atharvach2007/arsenal/j_imgs/Screenshot 2026-06-29 210843.png

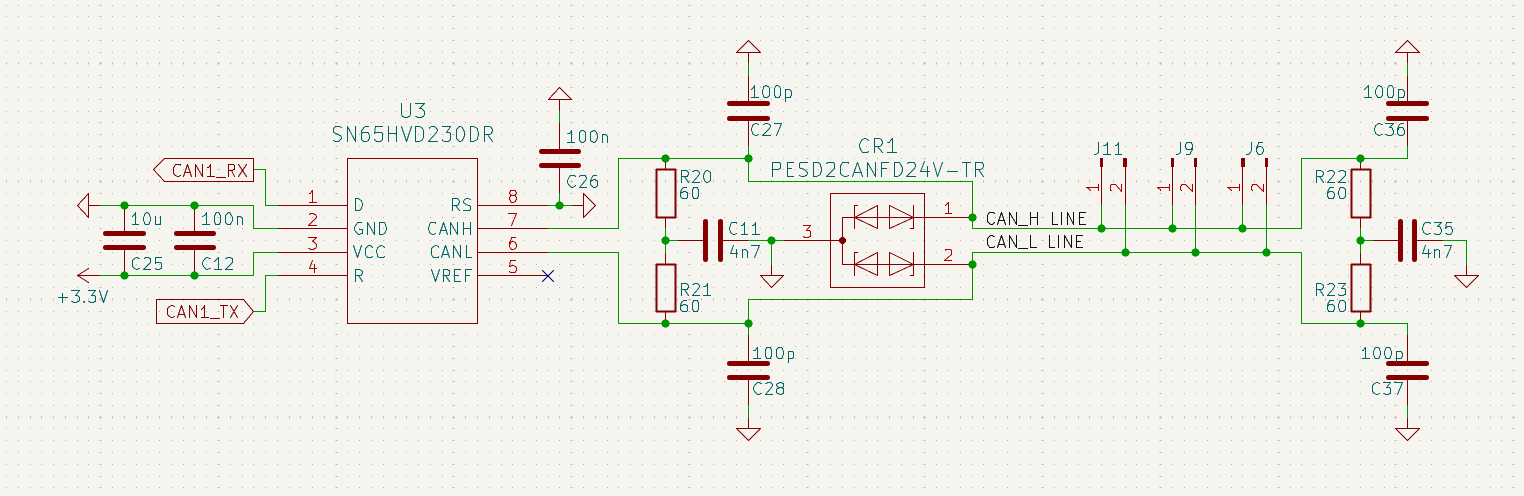
j_imgs/Screenshot 2026-06-29 210843.png
