atharvach2007/arsenal/j_imgs/Screenshot 2026-07-05 224754.png

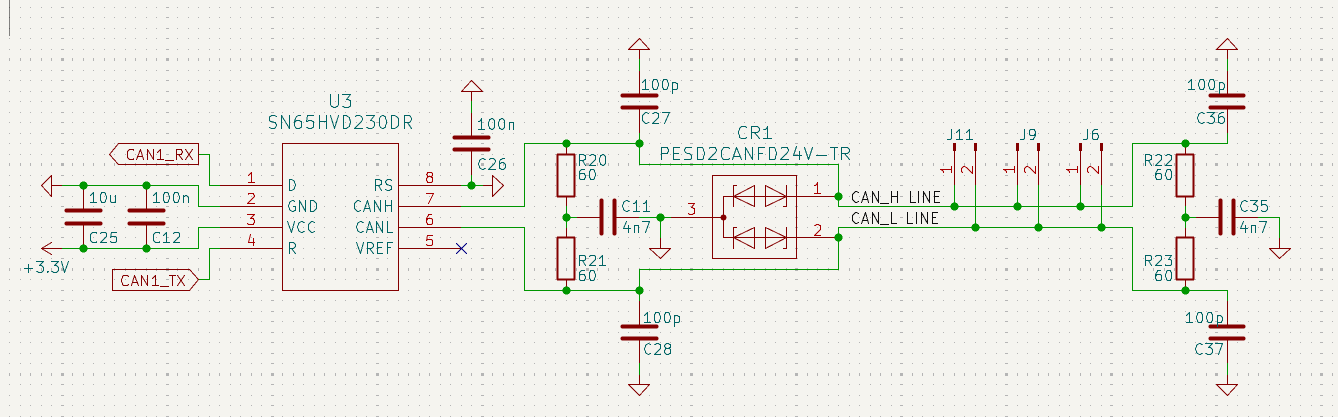
j_imgs/Screenshot 2026-07-05 224754.png
