atharvach2007/arsenal/assets/3D/SOT89-5_DIO.step

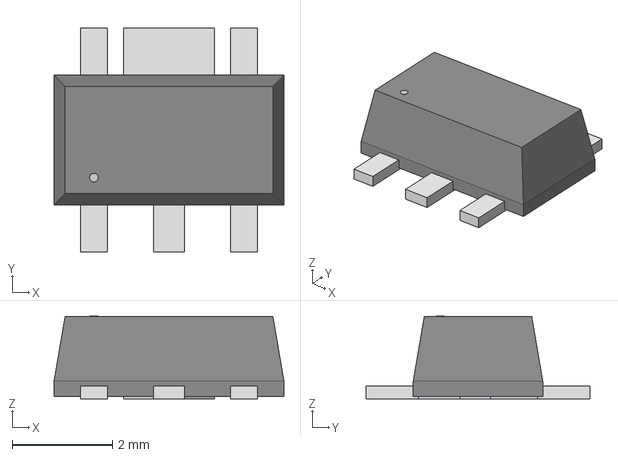
[picture p4: CAD file, 2026-06-28]
assets/3D/SOT89-5_DIO.step
4.60 x 4.47 x 1.65 mm
