atharvach2007/arsenal/assets/3D/XT60PW-M.stp

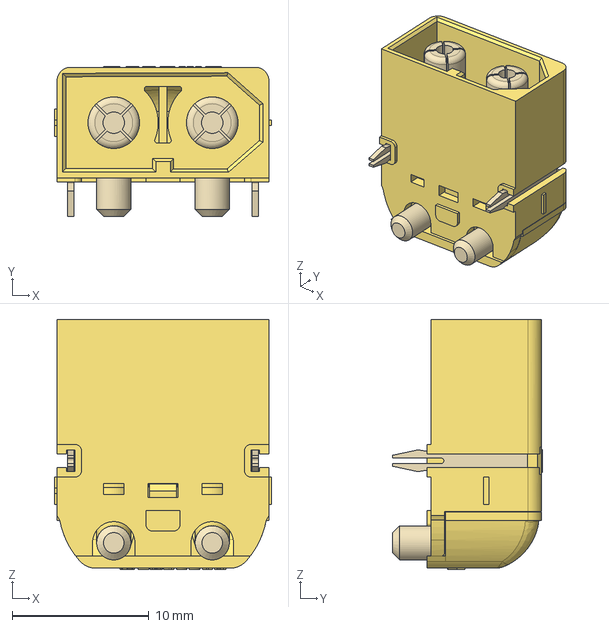
[picture p5: CAD file, 2026-06-28]
assets/3D/XT60PW-M.stp
15.9 x 10.9 x 18.3 mm
