atharvach2007/arsenal/assets/3D/TMC2209_SILENTSTEPSTICK.step

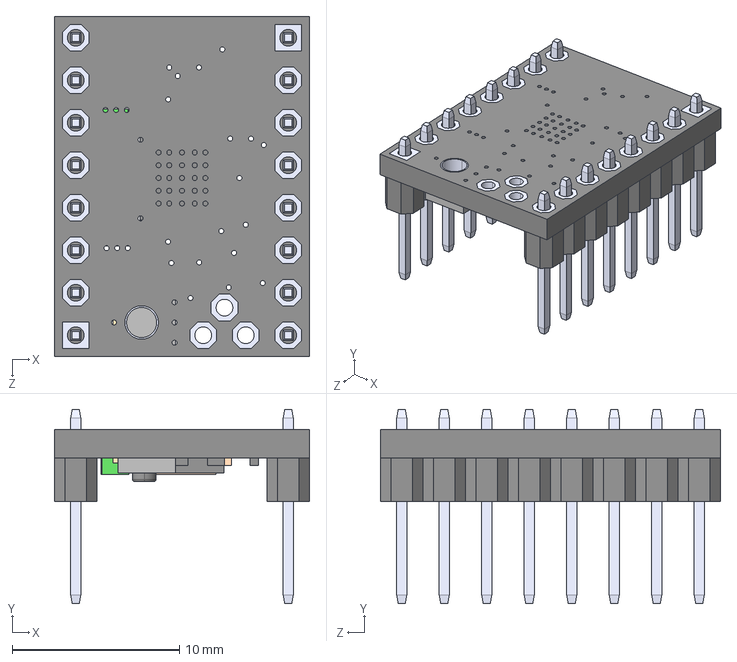
[picture p6: CAD file, 2026-06-28]
assets/3D/TMC2209_SILENTSTEPSTICK.step
15.2 x 11.6 x 20.3 mm
