atharvach2007/arsenal/assets/3D/STM32F446RET6.stp

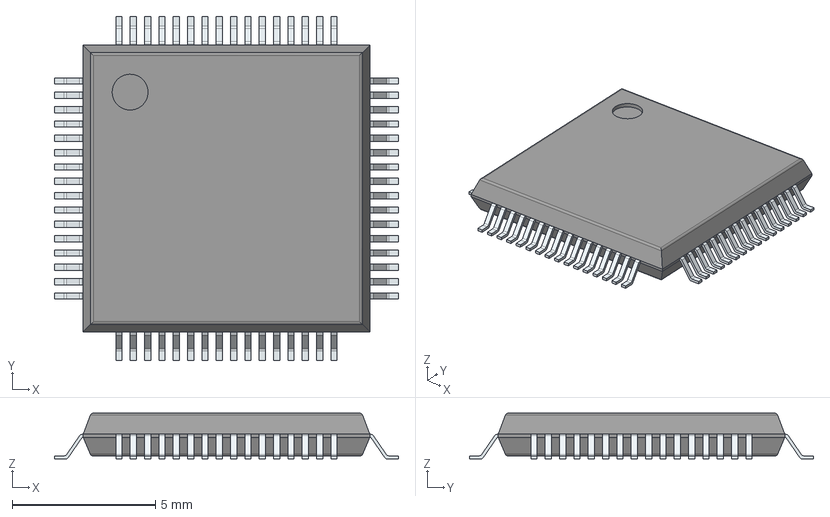
[picture p7: CAD file, 2026-05-29]
assets/3D/STM32F446RET6.stp
12.0 x 12.0 x 1.60 mm
PinsArrayLR
PinsArrayTB
