atharvach2007/arsenal/assets/3D/TPS54331DR.stp

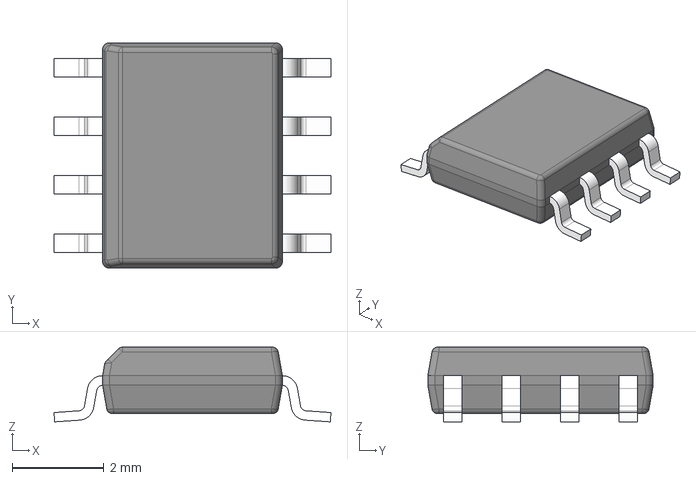
[picture p8: CAD file, 2026-06-28]
assets/3D/TPS54331DR.stp
6.02 x 4.90 x 1.63 mm
BODY-SO
LEAD-D0008A x 8
