atharvach2007/arsenal/assets/WBDesign1.pdf

## WEBENCH ® Design Report

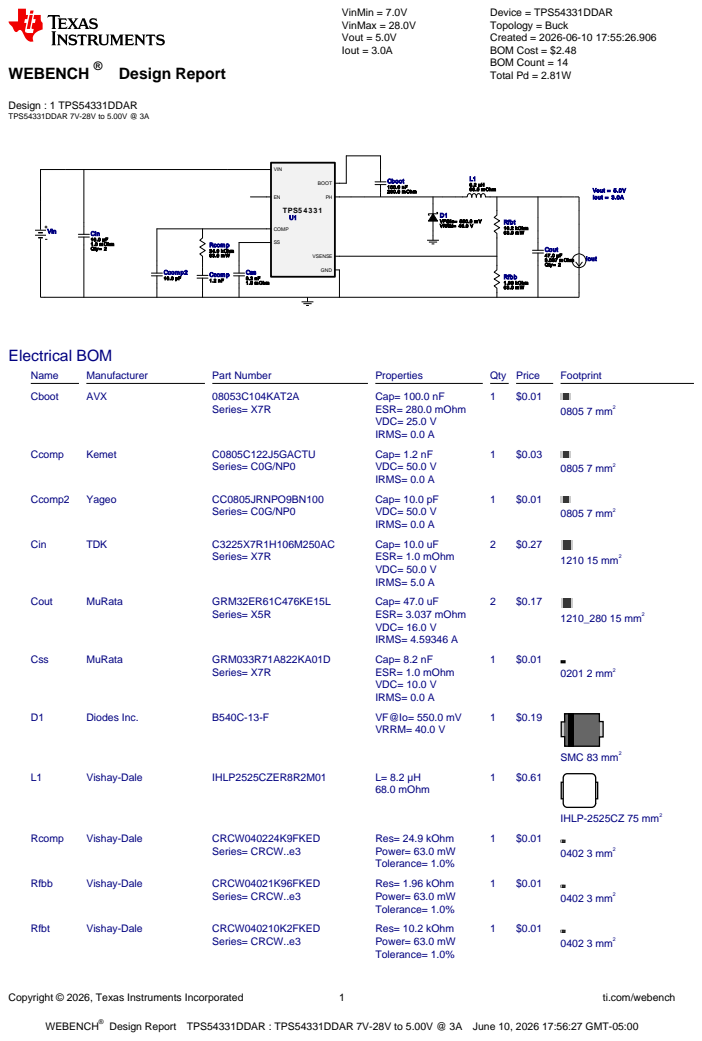
[picture p23: page 1]
Copyright © 2026, Texas Instruments Incorporated; ti.com/webench; WEBENCH®; Design : 1 TPS54331DDAR TPS54331DDAR 7V-28V to 5.00V @ 3A; VinMin = 7.0V VinMax = 28.0V Vout = 5.0V Iout = 3.0A; Device = TPS54331DDAR Topology = Buck Created = 2026-06-10 17:55:26.906 BOM Cost = $2.48 BOM Count = 14 Total Pd = 2.81W; Css 8.2 nF 1.0 m Ohm; Ccom p2 10.0 pF; TPS5 4 3 3 1; BOOT; VIN; VSENSE; COMP; GND; Rfbb 1.96 kOhm 63.0 m W; Cboot 100.0 nF 280.0 m Ohm; Cin 10.0 µF 1.0 m Ohm Qty= 2; L1 8.2 µH 68.0 m Ohm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

Design Report TPS54331DDAR : TPS54331DDAR 7V-28V to 5.00V @ 3A June 10, 2026 17:56:27 GMT-05:00

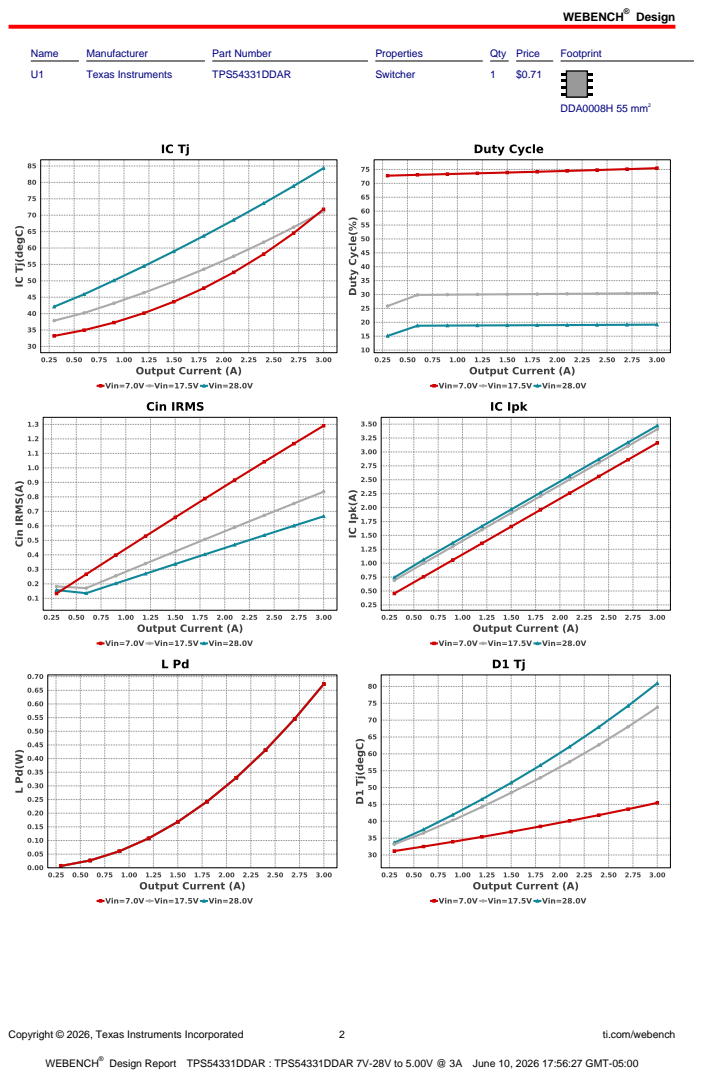
[picture p24: page 2]
Design; Copyright © 2026, Texas Instruments Incorporated; ti.com/webench; Name; Manufacturer; Part Number; Properties; Qty Price; Footprint; Texas Instruments; TPS54331DDAR; Switcher; DDA0008H 55 mm²

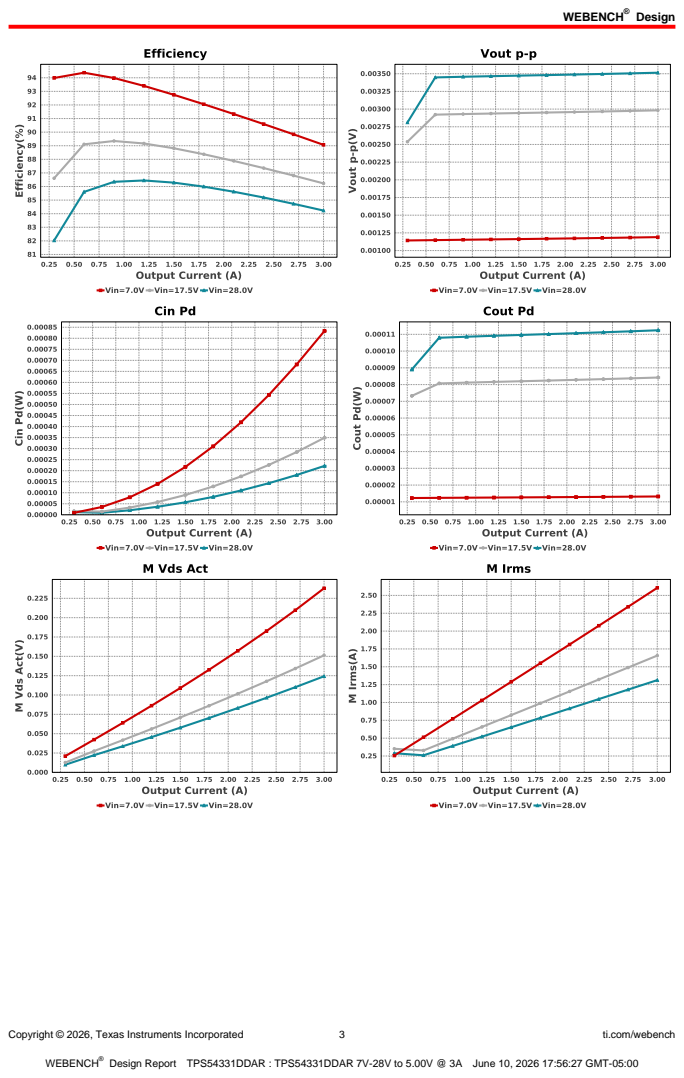
[picture p25: page 3]
Copyright © 2026, Texas Instruments Incorporated; ti.com/webench

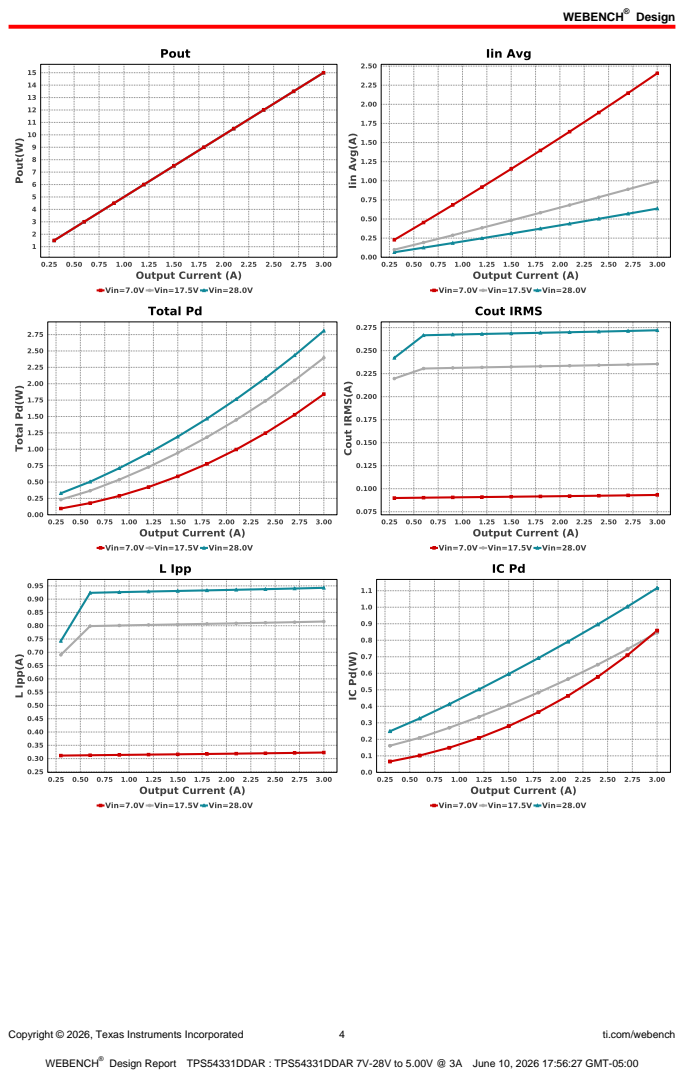
[picture p26: page 4]
Copyright © 2026, Texas Instruments Incorporated; ti.com/webench

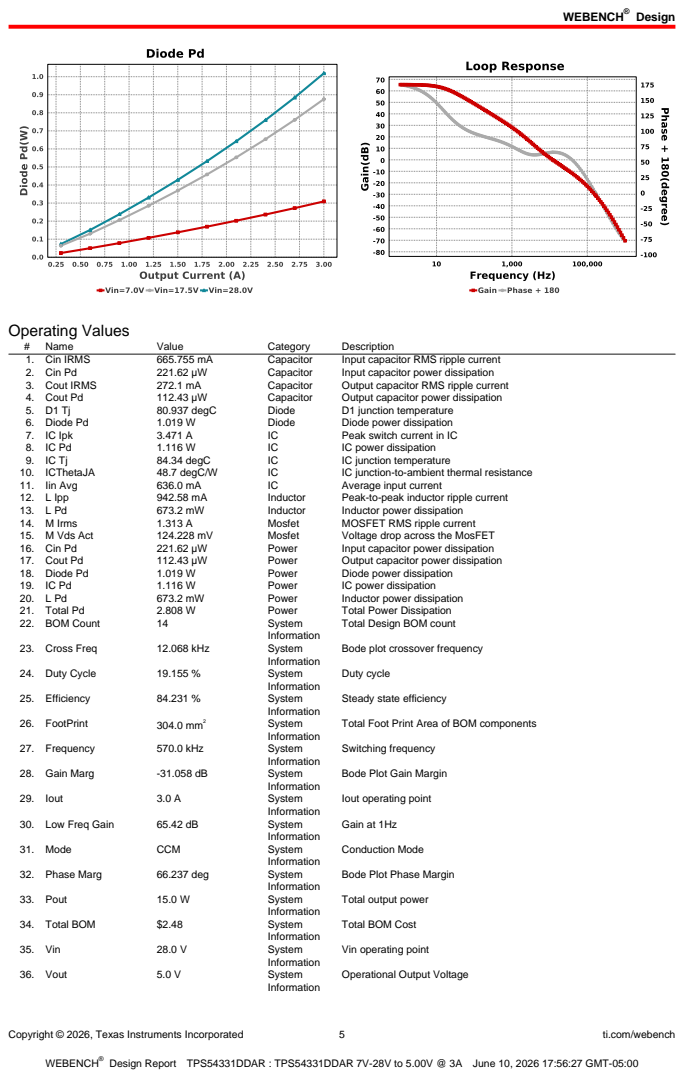
[picture p27: page 5]
Copyright © 2026, Texas Instruments Incorporated; ti.com/webench; Operating Values; Name; Value; Category; Description; 1. Cin IRMS; Capacitor; Input capacitor RMS ripple current; 2. Cin Pd; Input capacitor power dissipation; 3. Cout IRMS; Output capacitor RMS ripple current; 4. Cout Pd; Output capacitor power dissipation; 80.937 degC; Diode; D1 junction temperature; 6. Diode Pd; Diode power dissipation; 7. IC Ipk; Peak switch current in IC; IC power dissipation; 84.34 degC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

Total Design BOM count

Bode plot crossover frequency

Steady state efficiency

Total Foot Print Area of BOM components

Bode Plot Gain Margin

Iout operating point

Bode Plot Phase Margin

Total output power

Total BOM Cost

Vin operating point

Operational Output Voltage

Copyright © 2026, Texas Instruments Incorporated | 6 | ti.com/webench
# | Name | Value | Category | Description

37. Vout Actual | 4.963 V | System
| | | Information | Vout Actual calculated based on selected voltage divider resistors
38. Vout Tolerance | 5.254 % | System
| | | Information | Vout Tolerance based on IC Tolerance (no load) and voltage divider resistors if applicable
39. Vout p-p | 3.514 mV | System
| | | Information | Peak-to-peak output ripple voltage

## Design Inputs

Name | Value | Description
Iout | 3.0 | Maximum Output Current
VinMax | 28.0 | Maximum input voltage
VinMin | 7.0 | Minimum input voltage
Vout | 5.0 | Output Voltage
| base_pn | | TPS54331 | Base Product Number
source | DC | Input Source Type
Ta | 30.0 | Ambient temperature


Copyright © 2026, Texas Instruments Incorporated | 7 | ti.com/webench

## Assembly

## Component Testing

Some published data on components in datasheets such as Capacitor ESR and Inductor DC resistance is based on conservative values that will guarantee that the components always exceed the specification. For design purposes it is usually better to work with typical values. Since this data is not always available it is a good practice to measure the Capacitance and ESR values of Cin and Cout, and the inductance and DC resistance of L1 before assembly of the board. Any large discrepancies in values should be electrically simulated in WEBENCH to check for instabilities and thermally simulated in WebTHERM to make sure critical temperatures are not exceeded.

## Soldering Component to Board

If board assembly is done in house it is best to tack down one terminal of a component on the board then solder the other terminal. For surface mount parts with large tabs, such as the DPAK, the tab on the back of the package should be pre-tinned with solder, then tacked into place by one of the pins. To solder the tab town to the board place the iron down on the board while resting against the tab, heating both surfaces simultaneously. Apply light pressure to the top of the plastic case until the solder flows around the part and the part is flush with the PCB. If the solder is not flowing around the board you may need a higher wattage iron (generally 25W to 30W is enough).

## Initial Startup of Circuit

It is best to initially power up the board by setting the input supply voltage to the lowest operating input voltage 7.0V and set the input supply's current limit to zero. With the input supply off connect up the input supply to Vin and GND. Connect a digital volt meter and a load if needed to set the minimum Iout of the design from Vout and GND. Turn on the input supply and slowly turn up the current limit on the input supply. If the voltage starts to rise on the input supply continue increasing the input supply current limit while watching the output voltage. If the current increases on the input supply, but the voltage remains near zero, then there may be a short or a component misplaced on the board. Power down the board and visually inspect for solder bridges and recheck the diode and capacitor polarities. Once the power supply circuit is operational then more extensive testing may include full load testing, transient load and line tests to compare with simulation results.

## Load Testing

The setup is the same as the initial startup, except that an additional digital voltmeter is connected between Vin and GND, a load is connected between Vout and GND and a current meter is connected in series between Vout and the load. The load must be able to handle at least rated output power + 50% ( 7.5 watts for this design). Ideally the load is supplied in the form of a variable load test unit. It can also be done in the form of suitably large power resistors. When using an oscilloscope to measure waveforms on the prototype board, the ground leads of the oscilloscope probes should be as short as possible and the area of the loop formed by the ground lead should be kept to a minimum. This will help reduce ground lead inductance and eliminate EMI noise that is not actually present in the circuit.

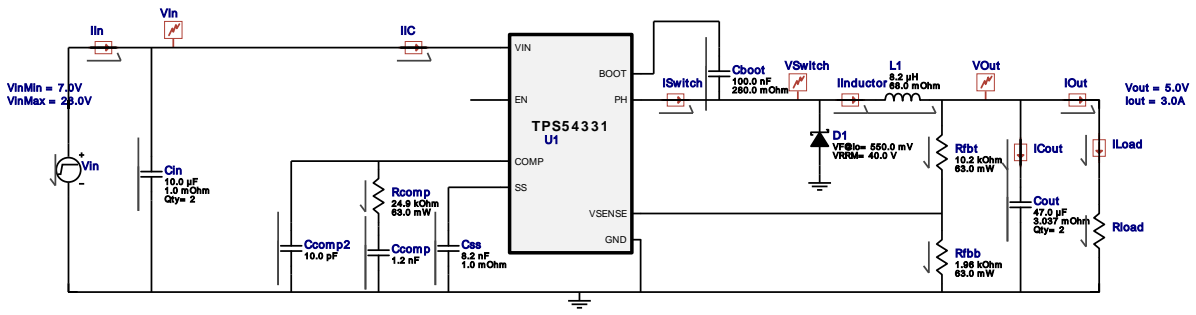
[picture p29: figure]
Css 8.2 nF 1.0 m Ohm; VinMin = 7.0V VinMax = 28.0V; VIn; ISwitch; VSwitch; ICout; Ccom p2 10.0 pF; TPS5 4 3 3 1; BOOT; VIN; VSENSE; COMP; GND; Rfbb 1.96 kOhm 63.0 m W; Cboot 100.0 nF; 280.0 m Ohm; IInductor; IIC; Cin 10.0 µF 1.0 m Ohm Qty= 2; L1 8.2 µH 68.0 m Ohm; Rfbt 10.2 kOhm 63.0 m W; IOut; Cout 47.0 µF 3.037 m Ohm Qty= 2; IIn; D1 VF@Io= 550.0 m V VRRM= 40.0 V; Ccom p 1.2 nF; Rcom p 24.9 kOhm 63.0 m W; Vout = 5.0V Iout = 3.0A; VOut; ILoad; Rload; Vin

Copyright © 2026, Texas Instruments Incorporated | 8 | ti.com/webench

## WEBENCH® Electrical Simulation Report

Design Id = 1
sim_id = 1
Simulation Type = Startup

## Simulation Parameters

# Name Parameter Name | Description | Values

1. Rload R | Load Resistance | 1.6666666666666667 Ohm

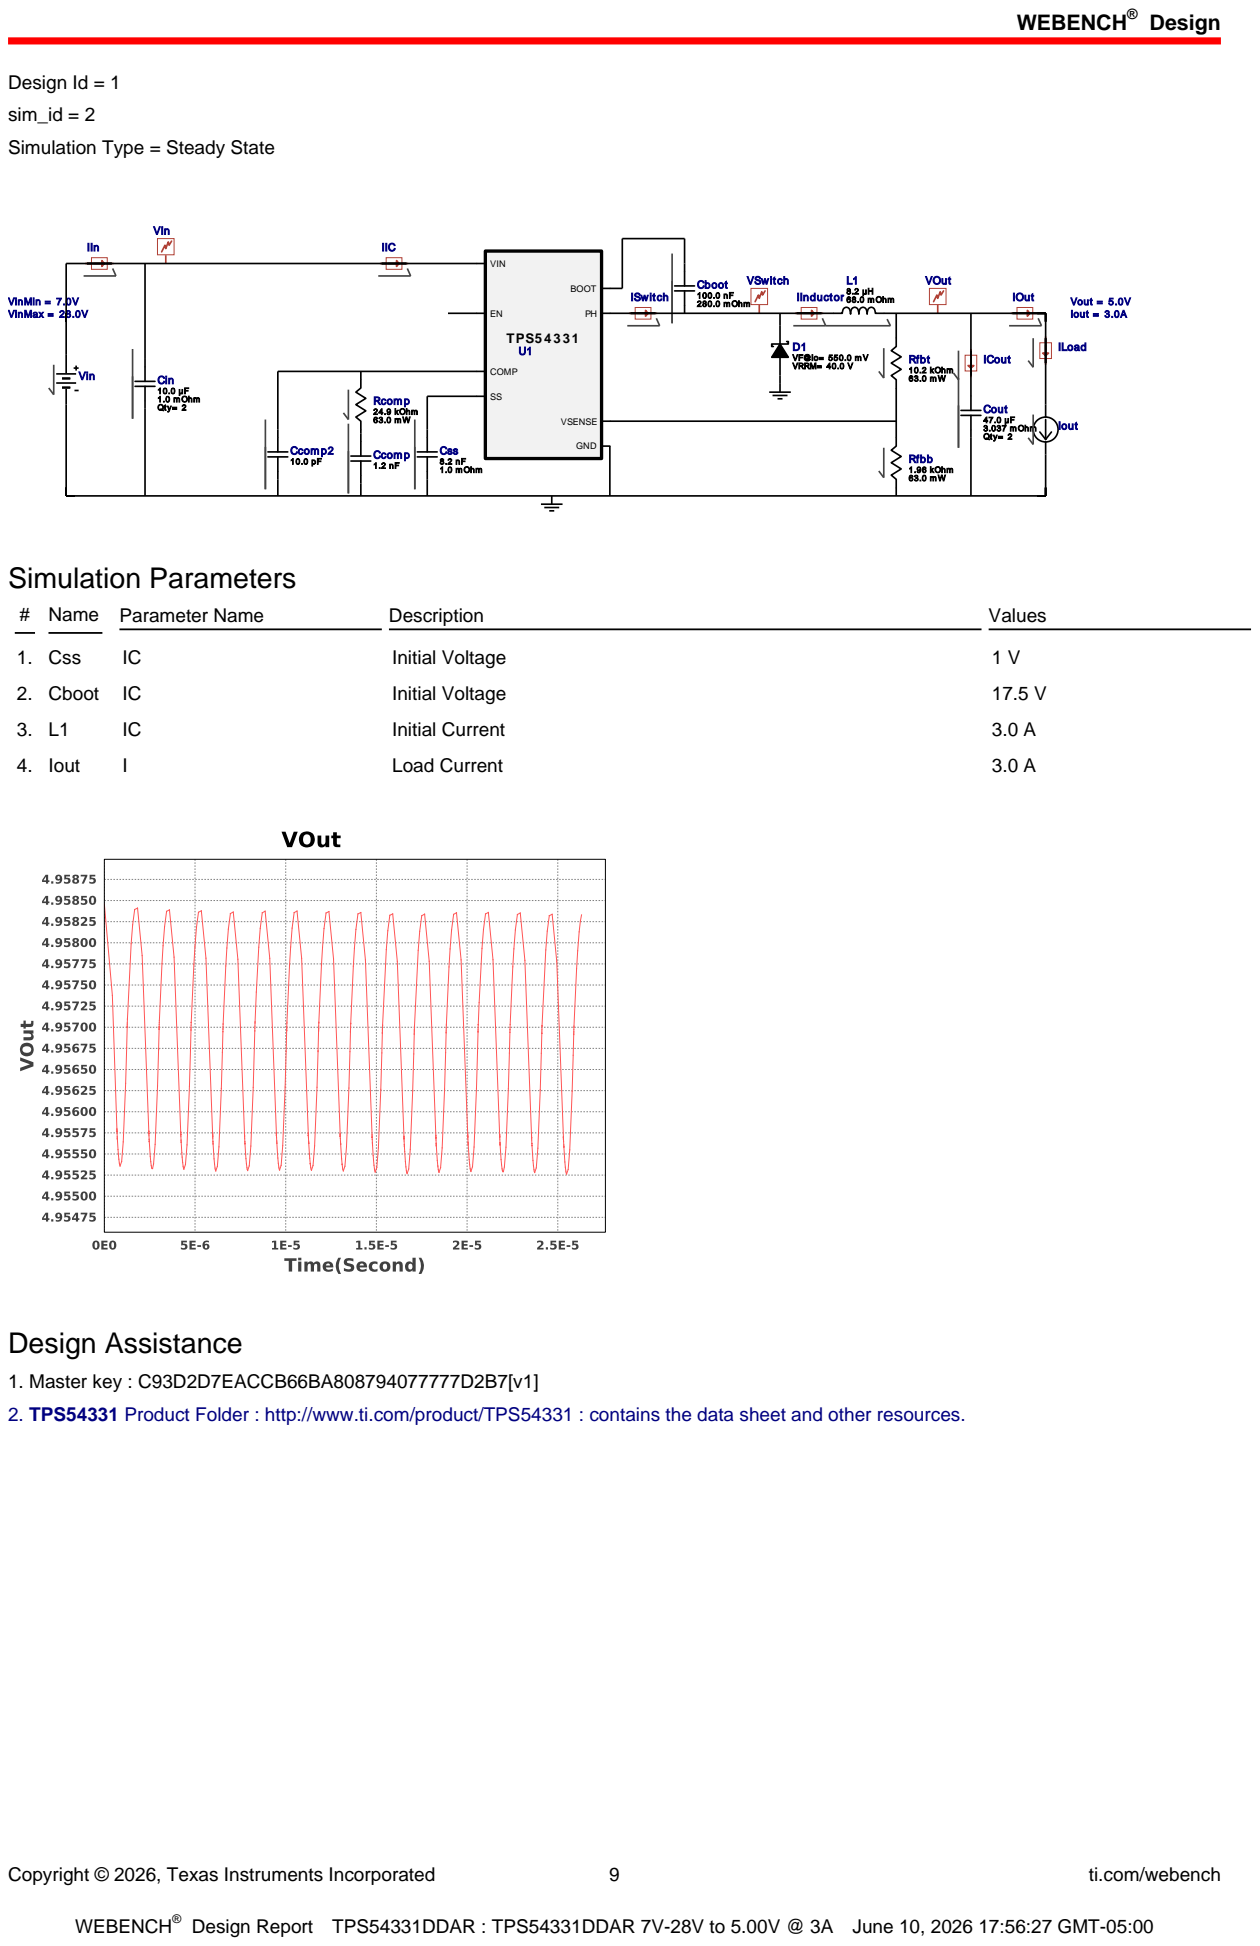
[picture p30: page 9]
Copyright © 2026, Texas Instruments Incorporated; ti.com/webench; Css 8.2 nF 1.0 m Ohm; VinMin = 7.0V VinMax = 28.0V; VIn; ISwitch; VSwitch; ICout; Ccom p2 10.0 pF; TPS5 4 3 3 1; BOOT; VIN; VSENSE; COMP; GND; Rfbb 1.96 kOhm 63.0 m W; Cboot 100.0 nF; 280.0 m Ohm; IInductor; IIC; Cin 10.0 µF 1.0 m Ohm Qty= 2; L1 8.2 µH 68.0 m Ohm; Rfbt 10.2 kOhm 63.0 m W; IOut; Cout 47.0 µF 3.037 m Ohm Qty= 2; IIn; D1 VF@Io= 550.0 m V VRRM= 40.0 V; Ccom p 1.2 nF; Rcom p 24.9 kOhm 63.0 m W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

Design Id = 1
sim_id = 2
Simulation Type = Steady State

1. Master key : C93D2D7EACCB66BA808794077777D2B7[v1]
2. TPS54331 Product Folder : http://www.ti.com/product/TPS54331 : contains the data sheet and other resources.

Copyright © 2026, Texas Instruments Incorporated | 10 | ti.com/webench

Important Notice and Disclaimer

TI provides technical and reliability data (including datasheets), design resources (including reference designs), application or other design advice, web tools, safety information, and other resources AS IS and with all faults, and disclaims all warranties. These resources are intended for skilled developers designing with TI products. You are solely responsible for (1) selecting the appropriate TI products for your application, (2) designing, validating and testing your application, and (3) ensuring your application meets applicable standards, and any other safety, security, or other requirements.

These resources are subject to change without notice. TI grants you permission to use these resources only for development of an application that uses the TI products described in the resource. Other reproduction and display of these resources is prohibited. No license is granted to any other TI intellectual property right or to any third party intellectual property right. TI disclaims responsibility for, and you will fully indemnify TI and its representatives against, any claims, damages, costs, losses, and liabilities arising out of your use of these resources.

Providing these resources does not expand or otherwise alter TI's applicable Terms of Sale or other applicable terms available either on ti.com or provided in conjunction with TI products.
