atharvach2007/arsenal/Stage1 - STM/voxboard/voxboard.pdf

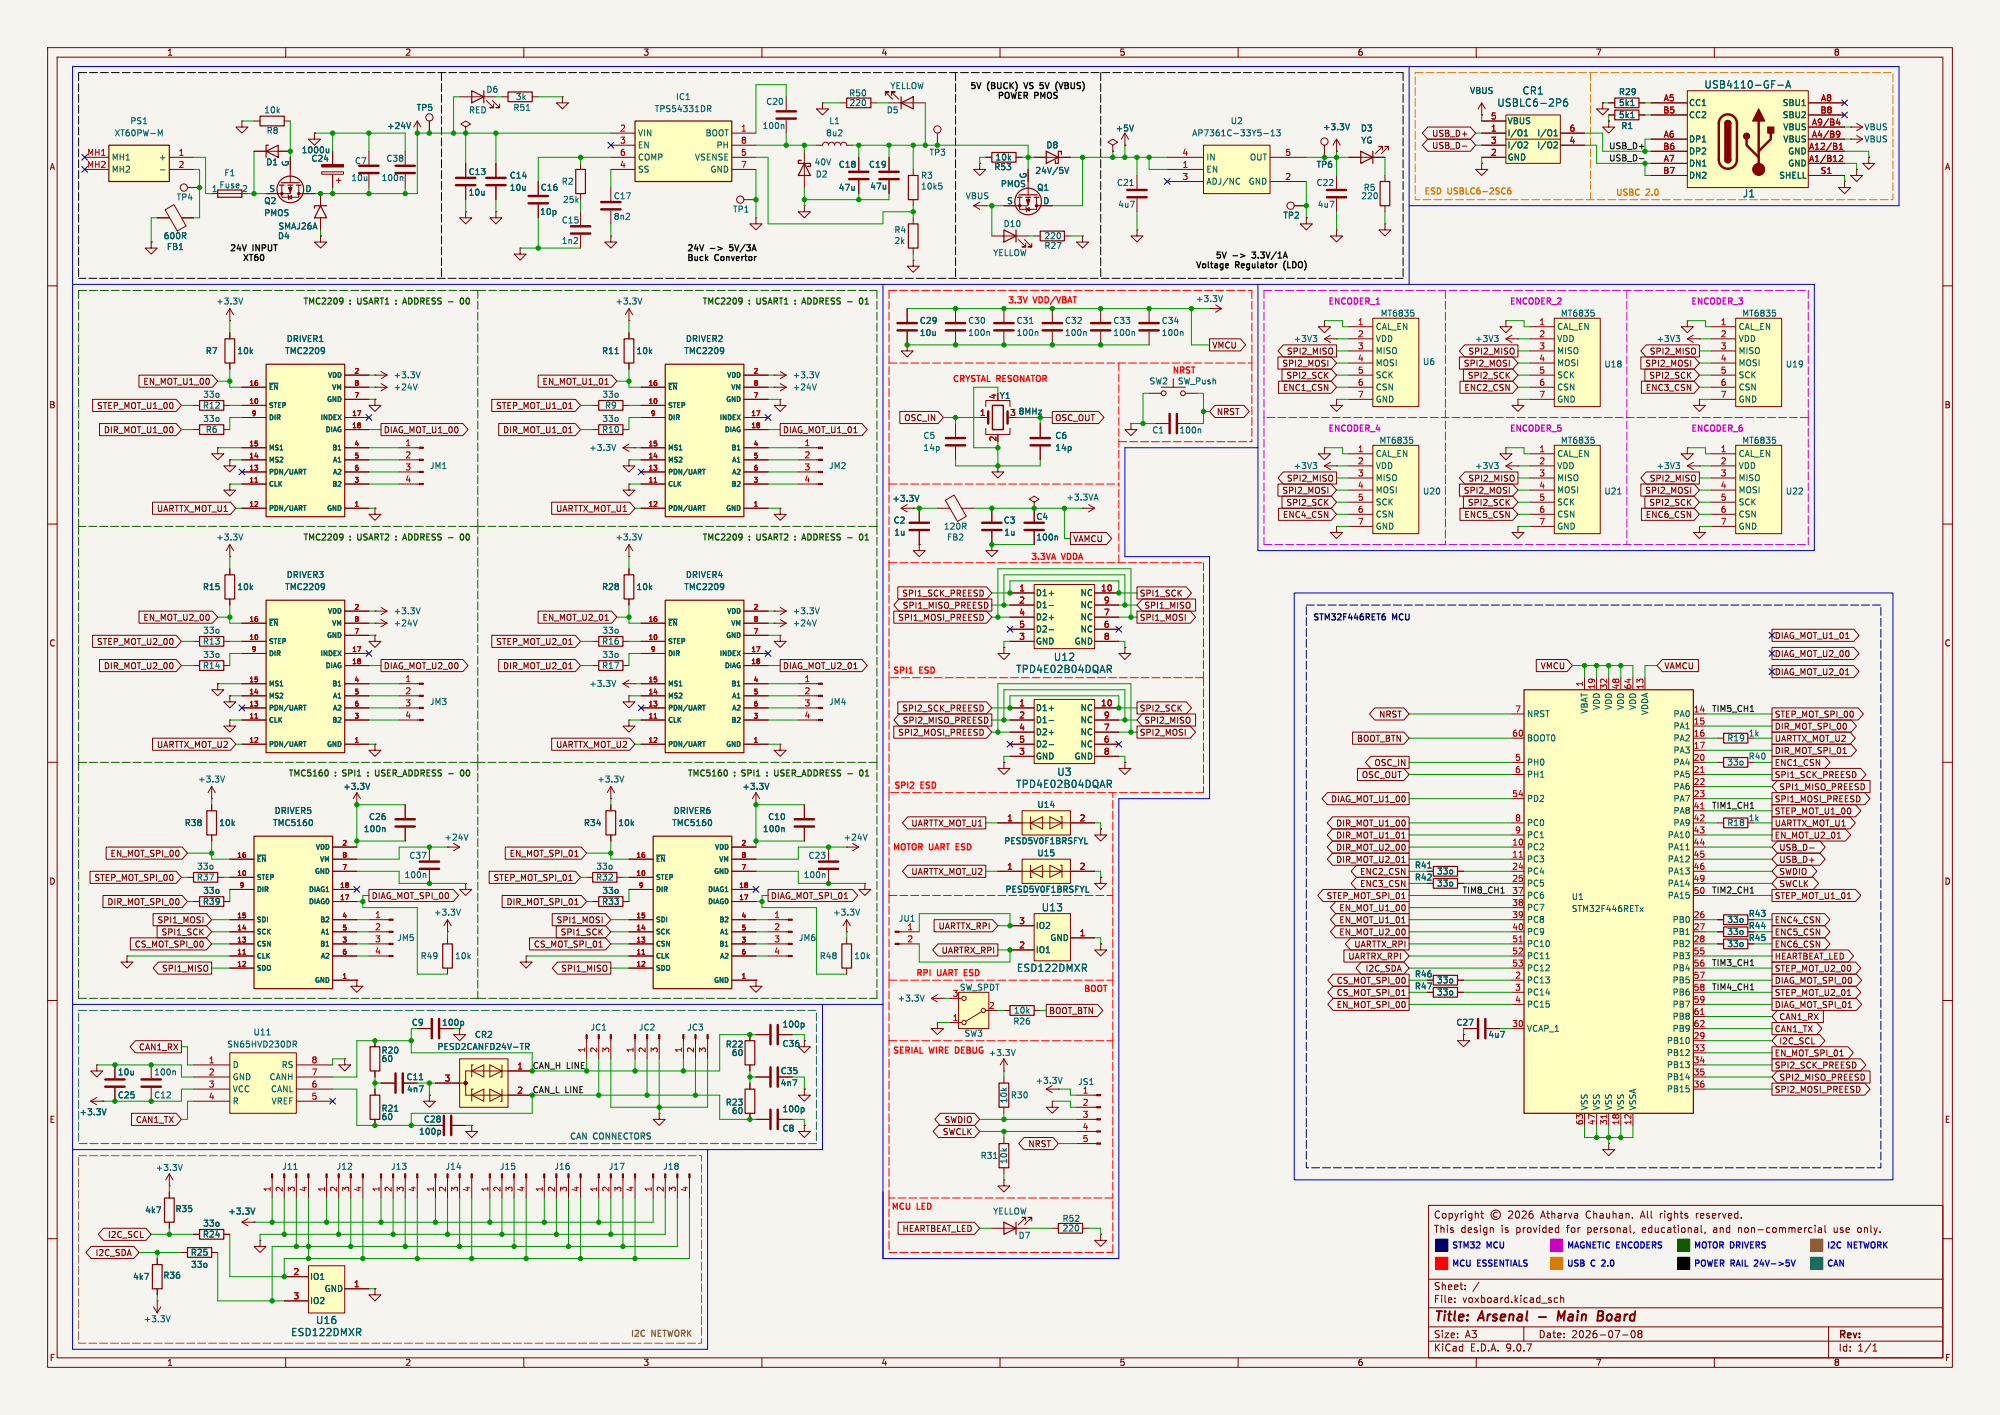
[picture p31: page 1]

5V (BUCK) VS 5V (VBUS) POWER PMOS

SPI1 ESD MOTOR UART ESD

1 VSS 63 VDD 19 VSS 47 VDD 32 VSS 31 VDD 48 VSS 18 VDD 64 VSSA 12 VDDA 13 PA0

Id: 1/1 Title: Arsenal - Main Board
