atharvach2007/arsenal/Stage1 - STM/voxboard/voxboard.kicad_pcb

## KiCad design Stage1 - STM/voxboard/voxboard.kicad_pcb (2026-07-23)

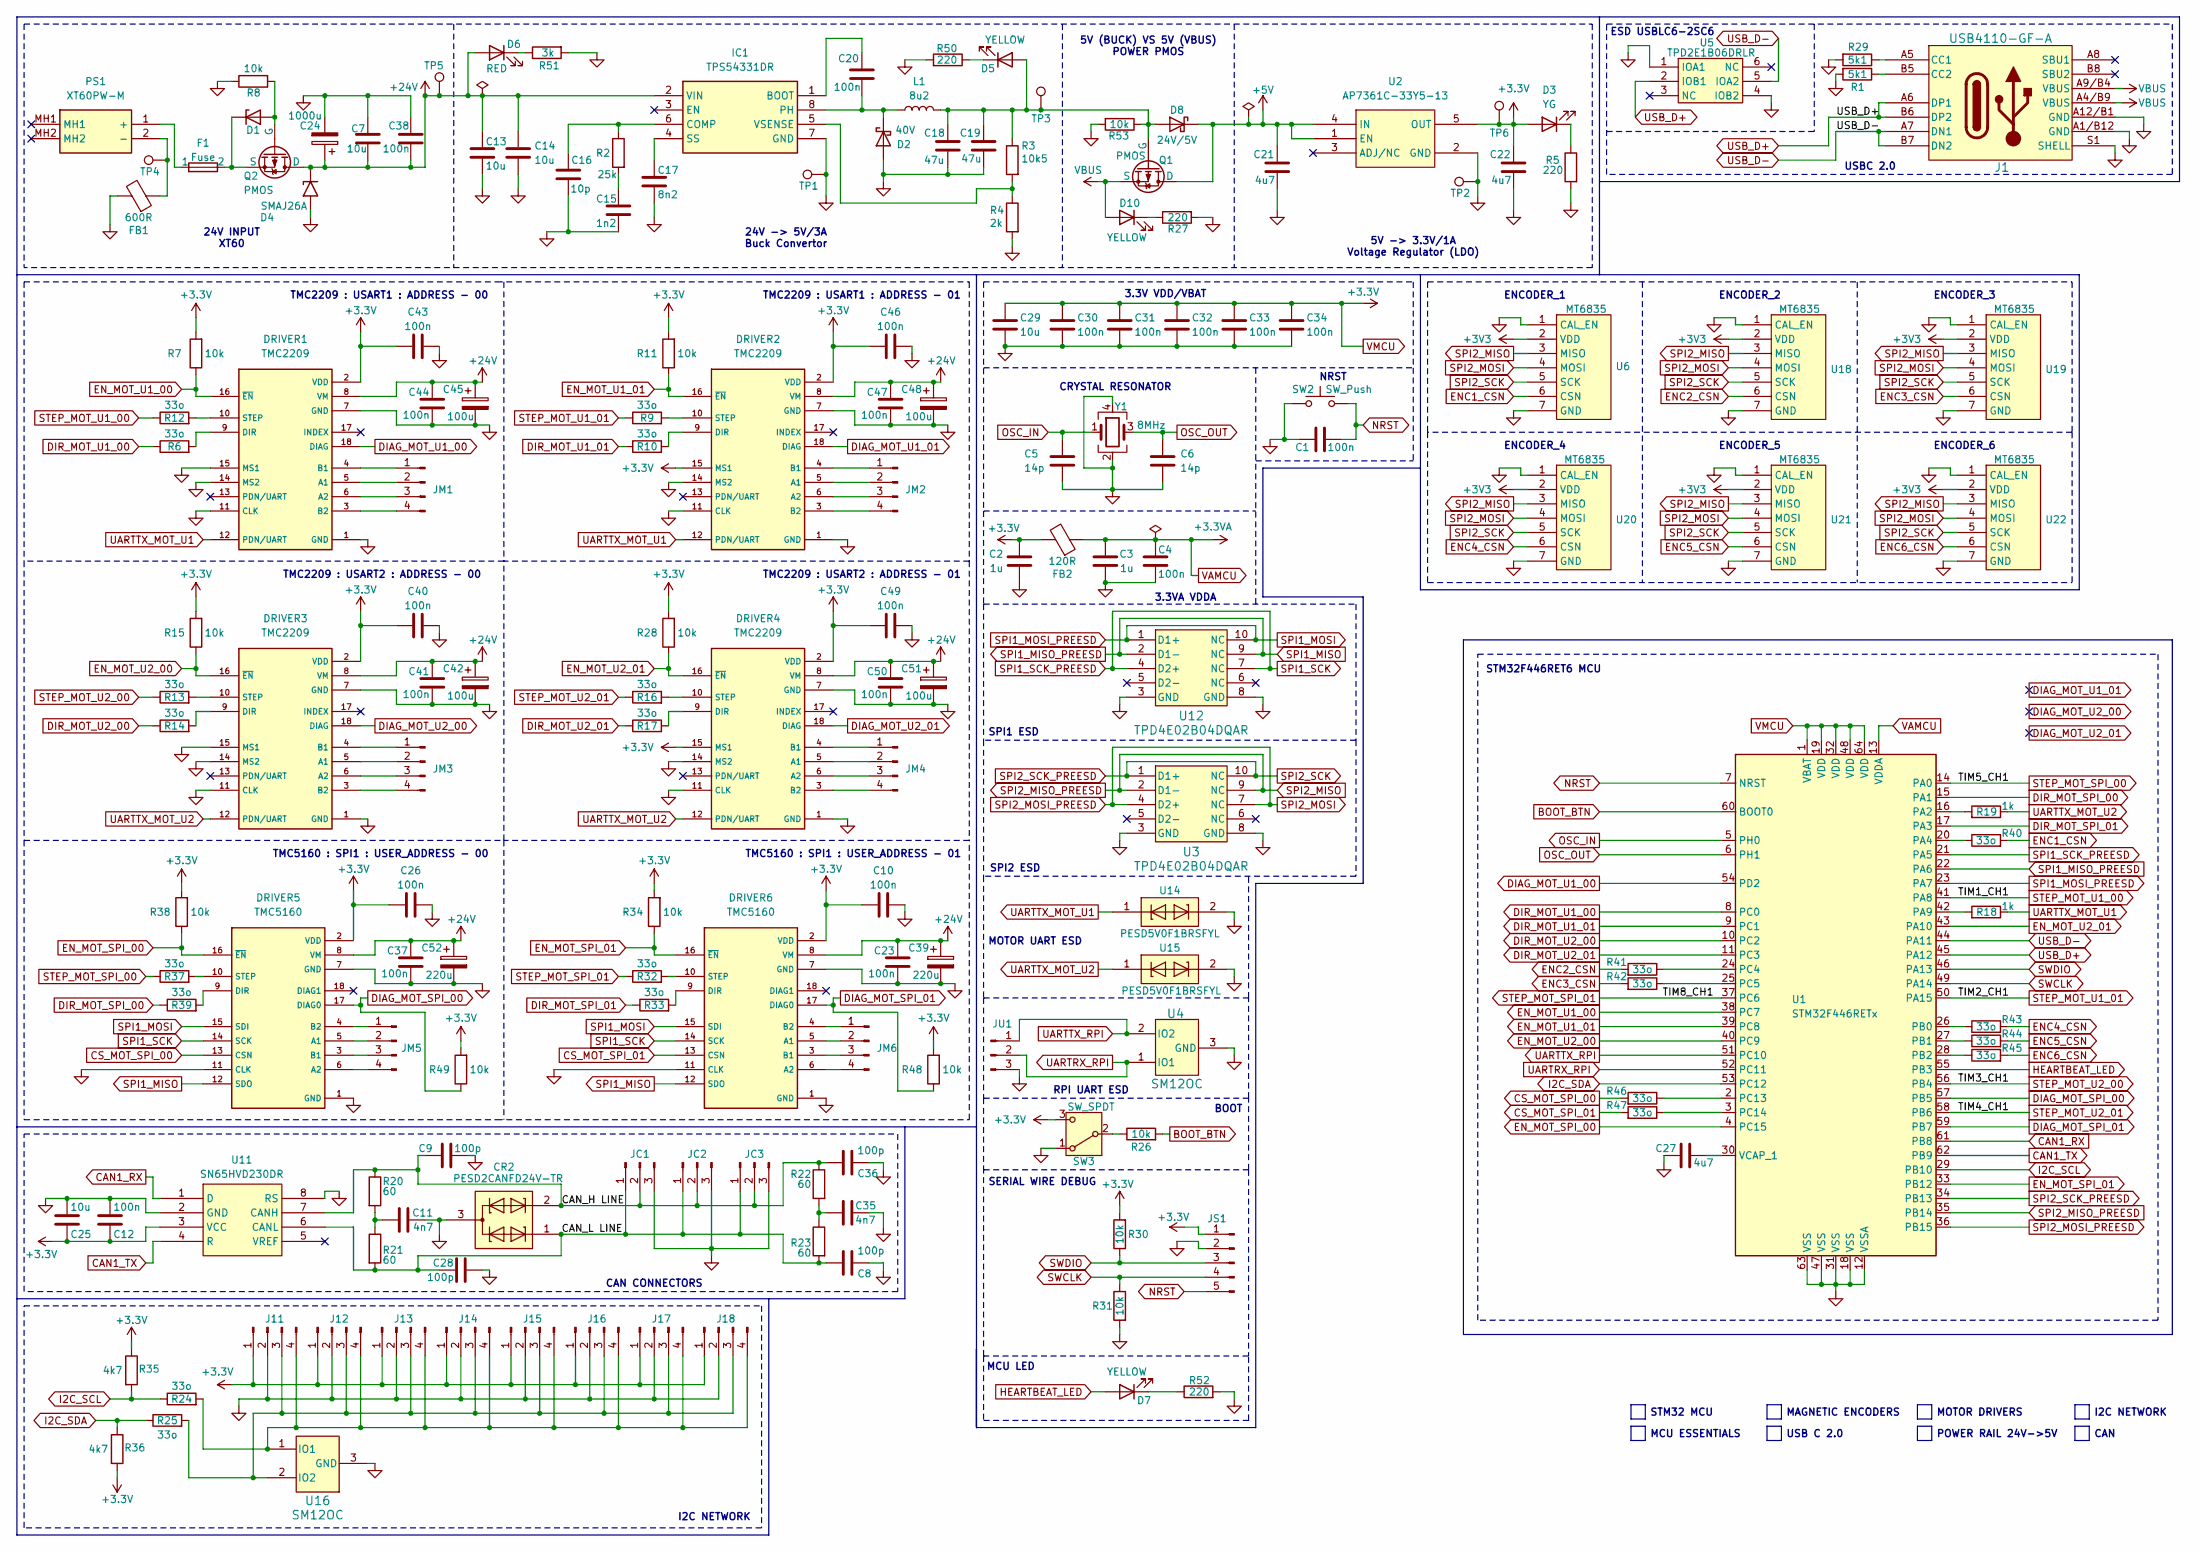
[picture p32: schematic voxboard.kicad_sch, Arsenal - Main Board]

Parts:
C1, C4, C10, C12, C23, C26, C30, C31, C32, C33, C34, C37, C38, C40, C41, C43, C44, C46, C47, C49, C50: 100n; C_0402_1005Metric
C2, C3: 1u; C_0603_1608Metric
C5, C6: 14p; C_0402_1005Metric
C7, C25, C29: 10u; C_0603_1608Metric
C8, C9, C28, C36: 100p; C_0402_1005Metric
C11, C35: 4n7; C_0402_1005Metric
C13, C14: 10u; C_1210_3225Metric
C15: 1n2; C_0805_2012Metric
C16: 10p; C_0805_2012Metric
C17: 8n2; C_0201_0603Metric
C18, C19: 47u; C_1210_3225Metric
C20: 100n; C_0805_2012Metric
C21, C22, C27: 4u7; C_0603_1608Metric
C24: 1000u; CP_Radial_D8.0mm_P3.50mm
C39, C52: 220u; CP_Radial_D10.0mm_P5.00mm
C42, C45, C48, C51: 100u; CP_Radial_D8.0mm_P3.50mm
CR2: PESD2CANFD24V-TR; SOT-23
D1: D_Zener; D_SOD-123
D2: 40V; D_SMA
D3: YG; LED_0603_1608Metric
D4: SMAJ26A; D_SMA
D5, D10: YELLOW; LED_0603_1608Metric
D6: RED; LED_0603_1608Metric
D7: YELLOW; LED_0805_2012Metric
D8: 24V/5V; D_SMC
DRIVER1, DRIVER2, DRIVER3, DRIVER4: TMC2209; MODULE_TMC2209_5160
DRIVER5, DRIVER6: TMC5160; MODULE_TMC2209_5160
F1: Fuse; CONN_3557-2_KEY
FB1: 600R; L_1210_3225Metric
FB2: 120R; L_0603_1608Metric
IC1: TPS54331DR; SOIC-8_3.9x4.9mm_P1.27mm
J1: USB4110-GF-A; USB_C_Receptacle_GCT_USB4110
J11, J12, J13, J14, J15, J16, J17, J18: Conn_01x04_Pin; JST_GH_BM04B-GHS-TBT_1x04-1MP_P1.25mm_Vertical
JC1, JC2, JC3: Conn_01x03_Pin; JST_GH_BM03B-GHS-TBT_1x03-1MP_P1.25mm_Vertical
JM1, JM2, JM3, JM4, JM5, JM6: Conn_01x04_Pin; JST_VH_B4P-VH-FB-B_1x04_P3.96mm_Vertical
JS1: Conn_01x05_Pin; PinHeader_1x05_P2.54mm_Vertical
JU1: Conn_01x03_Pin; PinHeader_1x03_P2.54mm_Vertical
L1: 8u2; L_KOHERELEC_MDA7050_7.3x6.6mm
PS1: XT60PW-M; AMASS_XT60PW-M_1x02_P7.20mm_Horizontal
Q1: PMOS; SOT-23
Q2: PMOS; TO-252-2
R1, R29: 5k1; R_0402_1005Metric
R2: 25k; R_0402_1005Metric
R3: 10k5; R_0402_1005Metric
R4: 2k; R_0402_1005Metric
R5, R27, R50, R52: 220; R_0402_1005Metric
R6, R9, R10, R12, R13, R14, R16, R17, R24, R25, R32, R33, R37, R39, R40, R41, R42, R43, R44, R45, R46, R47: 33o; R_0402_1005Metric
R7, R8, R11, R15, R26, R28, R30, R31, R34, R38, R48, R49, R53: 10k; R_0402_1005Metric
R18, R19: 1k; R_0402_1005Metric
R20, R21, R22, R23: 60; R_0603_1608Metric
R35, R36: 4k7; R_0402_1005Metric
R51: 3k; R_0402_1005Metric
SW2: SW_Push; SW_PUSH_B3U-1000PM
SW3: SW_SPDT; SW_SPDT_PCM12
TP1, TP2, TP4: TestPoint; TestPoint_Pad_2.0x2.0mm
TP3, TP5, TP6: TestPoint; TestPoint_Pad_D2.0mm
U1: STM32F446RETx; LQFP64-10x10mm
U2: AP7361C-33Y5-13; AP7361C-33Y5-13_SOT89-5_DIO
U3, U12: TPD4E02B04DQAR; USON-10_2.5x1.0mm_P0.5mm
U4, U16: SM12OC; SOT-23
U5: TPD2E1B06DRLR; SOT-666
U6, U18, U19, U20, U21, U22: MT6835; JST_GH_BM07B-GHS-TBT_1x07-1MP_P1.25mm_Vertical
U11: SN65HVD230DR; SOIC-8_3.9x4.9mm_P1.27mm
U14, U15: PESD5V0F1BRSFYL; Nexperia_DSN0603-2_0.6x0.3mm_P0.4mm
Y1: 8MHz; Crystal_SMD_3225-4Pin_3.2x2.5mm

Connections:
+3V3: U6.2 (VDD), U18.2 (VDD), U19.2 (VDD), U20.2 (VDD), U21.2 (VDD), U22.2 (VDD)
+5V: C21.1, D8.1 (K), Q1.1 (D), U2.1 (EN), U2.4 (IN)
+24V: C7.2, C13.1, C14.1, C23.1, C24.1, C37.1, C38.2, C39.1, C41.1, C42.1, C44.1, C45.1, C47.1, C48.1, C50.1, C51.1, C52.1, D4.1 (A1), D6.2 (A), DRIVER1.8 (VM), DRIVER2.8 (VM), DRIVER3.8 (VM), DRIVER4.8 (VM), DRIVER5.8 (VM), DRIVER6.8 (VM), IC1.2 (VIN), Q2.1 (D), TP5.1
/CAN_H LINE: C9.1, C36.1, CR2.2, JC1.2, JC2.2, JC3.2, R20.1, R22.1, U11.7 (CANH)
/CAN_L LINE: C8.1, C28.1, CR2.1, JC1.1, JC2.1, JC3.1, R21.2, R23.2, U11.6 (CANL)
BOOT_BTN: R26.2, U1.60 (BOOT0)
CAN1_RX: U1.61 (PB8), U11.1 (D)
CAN1_TX: U1.62 (PB9), U11.4 (R)
CS_MOT_SPI_00: DRIVER5.13 (CSN), R46.2
CS_MOT_SPI_01: DRIVER6.13 (CSN), R47.2
DIAG_MOT_SPI_00: DRIVER5.17 (DIAG0), R49.1, U1.57 (PB5)
DIAG_MOT_SPI_01: DRIVER6.17 (DIAG0), R48.1, U1.59 (PB7)
DIAG_MOT_U1_00: DRIVER1.18 (DIAG), U1.54 (PD2)
DIAG_MOT_U1_01: DRIVER2.18 (DIAG)
DIAG_MOT_U2_00: DRIVER3.18 (DIAG)
DIAG_MOT_U2_01: DRIVER4.18 (DIAG)
DIR_MOT_SPI_00: R39.1, U1.15 (PA1)
DIR_MOT_SPI_01: R33.1, U1.17 (PA3)
DIR_MOT_U1_00: R6.1, U1.8 (PC0)
DIR_MOT_U1_01: R10.1, U1.9 (PC1)
DIR_MOT_U2_00: R14.1, U1.10 (PC2)
DIR_MOT_U2_01: R17.1, U1.11 (PC3)
ENC1_CSN: R40.2, U6.6 (CSN)
ENC2_CSN: R41.2, U18.6 (CSN)
ENC3_CSN: R42.2, U19.6 (CSN)
ENC4_CSN: R43.2, U20.6 (CSN)
ENC5_CSN: R44.2, U21.6 (CSN)
ENC6_CSN: R45.2, U22.6 (CSN)
EN_MOT_SPI_00: DRIVER5.16 (~EN), R38.1, U1.4 (PC15)
EN_MOT_SPI_01: DRIVER6.16 (~EN), R34.1, U1.33 (PB12)
EN_MOT_U1_00: DRIVER1.16 (~EN), R7.1, U1.38 (PC7)
EN_MOT_U1_01: DRIVER2.16 (~EN), R11.1, U1.39 (PC8)
EN_MOT_U2_00: DRIVER3.16 (~EN), R15.1, U1.40 (PC9)
EN_MOT_U2_01: DRIVER4.16 (~EN), R28.1, U1.43 (PA10)
GND: C1.1, C2.2, C3.2, C4.2, C5.2, C6.2, C7.1, C8.2, C9.2, C10.2, C11.2, C12.2, C13.2, C14.2, C15.2, C16.2, C17.2, C18.2, C19.2, C21.2, C22.2, C23.2, C24.2, C25.2, C26.2, C27.1, C28.2, C29.2, C30.2, C31.2, C32.2, C33.2, C34.2, C35.2, C36.2, C37.2, C38.1, C39.2, C40.2, C41.2, C42.2, C43.2, C44.2, C45.2, C46.2, C47.2, C48.2, C49.2, C50.2, C51.2, C52.2, CR2.3, D2.2 (A), D4.2 (A2), DRIVER1.1 (GND), DRIVER1.7 (GND), DRIVER1.11 (CLK), DRIVER1.14 (MS2), DRIVER1.15 (MS1), DRIVER2.1 (GND), DRIVER2.7 (GND), DRIVER2.11 (CLK), DRIVER2.14 (MS2), DRIVER3.1 (GND), DRIVER3.7 (GND), DRIVER3.11 (CLK), DRIVER3.14 (MS2), DRIVER3.15 (MS1), DRIVER4.1 (GND), DRIVER4.7 (GND), DRIVER4.11 (CLK), DRIVER4.14 (MS2), DRIVER5.1 (GND), DRIVER5.7 (GND), DRIVER5.11 (CLK), DRIVER6.1 (GND), DRIVER6.7 (GND), DRIVER6.11 (CLK), FB1.2, IC1.7 (GND), J1.A1/B12 (GND), J1.A12/B1 (GND), J1.S1 (SHELL), J11.2, J12.2, J13.2, J14.2, J15.2, J16.2, J17.2, J18.2, JC1.3, JC2.3, JC3.3, JS1.2, JU1.3, R1.2, R4.2, R5.2, R8.1, R27.2, R29.2, R31.2, R50.2, R51.2, R52.2, R53.2, SW2.1, SW3.1 (A), TP1.1, TP2.1, U1.12 (VSSA), U1.18 (VSS), U1.31 (VSS), U1.47 (VSS), U1.63 (VSS), U2.2 (GND), U3.3 (GND), U3.8 (GND), U4.3 (GND), U5.1 (IOA1), U5.4 (IOB2), U6.1 (CAL_EN), U6.7 (GND), U11.2 (GND), U11.8 (RS), U12.3 (GND), U12.8 (GND), U14.2, U15.2, U16.3 (GND), U18.1 (CAL_EN), U18.7 (GND), U19.1 (CAL_EN), U19.7 (GND), U20.1 (CAL_EN), U20.7 (GND), U21.1 (CAL_EN), U21.7 (GND), U22.1 (CAL_EN), U22.7 (GND), Y1.2 (G), Y1.4 (G)
HEARTBEAT_LED: D7.2 (A), U1.55 (PB3)
I2C_SCL: R24.1, R35.2, U1.29 (PB10)
I2C_SDA: R25.1, R36.1, U1.53 (PC12)
NRST: C1.2, JS1.5, SW2.2, U1.7 (NRST)
unnamed: C11.1, R20.2, R21.1
unnamed: C15.1, R2.2
unnamed: C35.1, R22.2, R23.1
unnamed: D1.2 (A), Q2.2 (G), R8.2
unnamed: D1.1 (K), F1.2, Q2.3 (S)
unnamed: C20.2, D2.1 (K), IC1.8 (PH), L1.1
unnamed: D3.1 (K), R5.1
unnamed: C18.1, C19.1, D5.2 (A), D8.2 (A), L1.2, Q1.2 (G), R3.1, R53.1, TP3.1
unnamed: D5.1 (K), R50.1
unnamed: D6.1 (K), R51.1
unnamed: D7.1 (K), R52.1
unnamed: D10.1 (K), R27.1
unnamed: DRIVER1.5 (A1), JM1.2
unnamed: DRIVER1.6 (A2), JM1.3
unnamed: DRIVER1.4 (B1), JM1.1
unnamed: DRIVER1.3 (B2), JM1.4
unnamed: DRIVER1.9 (DIR), R6.2
unnamed: DRIVER1.10 (STEP), R12.2
unnamed: DRIVER2.5 (A1), JM2.2
unnamed: DRIVER2.6 (A2), JM2.3
unnamed: DRIVER2.4 (B1), JM2.1
unnamed: DRIVER2.3 (B2), JM2.4
unnamed: DRIVER2.9 (DIR), R10.2
unnamed: DRIVER2.10 (STEP), R9.2
unnamed: DRIVER3.5 (A1), JM3.2
unnamed: DRIVER3.6 (A2), JM3.3
unnamed: DRIVER3.4 (B1), JM3.1
unnamed: DRIVER3.3 (B2), JM3.4
unnamed: DRIVER3.9 (DIR), R14.2
unnamed: DRIVER3.10 (STEP), R13.2
unnamed: DRIVER4.5 (A1), JM4.2
unnamed: DRIVER4.6 (A2), JM4.3
unnamed: DRIVER4.4 (B1), JM4.1
unnamed: DRIVER4.3 (B2), JM4.4
unnamed: DRIVER4.9 (DIR), R17.2
unnamed: DRIVER4.10 (STEP), R16.2
unnamed: DRIVER5.5 (A1), JM5.2
unnamed: DRIVER5.6 (A2), JM5.4
unnamed: DRIVER5.3 (B1), JM5.3
unnamed: DRIVER5.4 (B2), JM5.1
unnamed: DRIVER5.9 (DIR), R39.2
unnamed: DRIVER5.10 (STEP), R37.2
unnamed: DRIVER6.5 (A1), JM6.2
unnamed: DRIVER6.6 (A2), JM6.4
unnamed: DRIVER6.3 (B1), JM6.3
unnamed: DRIVER6.4 (B2), JM6.1
unnamed: DRIVER6.9 (DIR), R33.2
unnamed: DRIVER6.10 (STEP), R32.2
unnamed: C20.1, IC1.1 (BOOT)
unnamed: C16.1, IC1.6 (COMP), R2.1
unnamed: C17.1, IC1.4 (SS)
unnamed: IC1.5 (VSENSE), R3.2, R4.1
unnamed: J1.A5 (CC1), R29.1
unnamed: J1.B5 (CC2), R1.1
unnamed: J11.3, J12.3, J13.3, J14.3, J15.3, J16.3, J17.3, J18.3, R25.2, U16.2 (IO2)
unnamed: J11.4, J12.4, J13.4, J14.4, J15.4, J16.4, J17.4, J18.4, R24.2, U16.1 (IO1)
unnamed: F1.1, PS1.1 (+)
unnamed: FB1.1, PS1.2 (-), TP4.1
unnamed: R26.1, SW3.2 (B)
unnamed: R19.2, U1.16 (PA2)
unnamed: R40.1, U1.20 (PA4)
unnamed: R18.2, U1.42 (PA9)
unnamed: R43.1, U1.26 (PB0)
unnamed: R44.1, U1.27 (PB1)
unnamed: R45.1, U1.28 (PB2)
unnamed: R41.1, U1.24 (PC4)
unnamed: R42.1, U1.25 (PC5)
unnamed: R46.1, U1.2 (PC13)
unnamed: R47.1, U1.3 (PC14)
unnamed: C27.2, U1.30 (VCAP_1)
OSC_IN: C5.1, U1.5 (PH0), Y1.1
OSC_OUT: C6.1, U1.6 (PH1), Y1.3
SPI1_MISO: DRIVER5.12 (SDO), DRIVER6.12 (SDO), U1.22 (PA6), U12.2 (D1-), U12.9 (NC)
SPI1_MOSI: DRIVER5.15 (SDI), DRIVER6.15 (SDI), U1.23 (PA7), U12.1 (D1+), U12.10 (NC)
SPI1_SCK: DRIVER5.14 (SCK), DRIVER6.14 (SCK), U1.21 (PA5), U12.4 (D2+), U12.7 (NC)
SPI2_MISO: U1.35 (PB14), U3.2 (D1-), U3.9 (NC), U6.3 (MISO), U18.3 (MISO), U19.3 (MISO), U20.3 (MISO), U21.3 (MISO), U22.3 (MISO)
SPI2_MOSI: U1.36 (PB15), U3.4 (D2+), U3.7 (NC), U6.4 (MOSI), U18.4 (MOSI), U19.4 (MOSI), U20.4 (MOSI), U21.4 (MOSI), U22.4 (MOSI)
SPI2_SCK: U1.34 (PB13), U3.1 (D1+), U3.10 (NC), U6.5 (SCK), U18.5 (SCK), U19.5 (SCK), U20.5 (SCK), U21.5 (SCK), U22.5 (SCK)
STEP_MOT_SPI_00: R37.1, U1.14 (PA0)
STEP_MOT_SPI_01: R32.1, U1.37 (PC6)
STEP_MOT_U1_00: R12.1, U1.41 (PA8)
STEP_MOT_U1_01: R9.1, U1.50 (PA15)
STEP_MOT_U2_00: R13.1, U1.56 (PB4)
STEP_MOT_U2_01: R16.1, U1.58 (PB6)
SWCLK: JS1.4, R31.1, U1.49 (PA14)
SWDIO: JS1.3, R30.1, U1.46 (PA13)
UARTRX_RPI: JU1.2, U1.52 (PC11), U4.1 (IO1)
UARTTX_MOT_U1: DRIVER1.12 (PDN/UART), DRIVER2.12 (PDN/UART), R18.1, U14.1
UARTTX_MOT_U2: DRIVER3.12 (PDN/UART), DRIVER4.12 (PDN/UART), R19.1, U15.1
UARTTX_RPI: JU1.1, U1.51 (PC10), U4.2 (IO2)
USB_D+: J1.A6 (DP1), J1.B6 (DP2), U1.45 (PA12), U5.2 (IOB1)
USB_D-: J1.A7 (DN1), J1.B7 (DN2), U1.44 (PA11), U5.5 (IOA2)
VAMCU: C3.1, C4.1, FB2.1, U1.13 (VDDA)
VBUS: D10.2 (A), J1.A4/B9 (VBUS), J1.A9/B4 (VBUS), Q1.3 (S)
VMCU: C2.1, C10.1, C12.1, C22.1, C25.1, C26.1, C29.1, C30.1, C31.1, C32.1, C33.1, C34.1, C40.1, C43.1, C46.1, C49.1, D3.2 (A), DRIVER1.2 (VDD), DRIVER2.2 (VDD), DRIVER2.15 (MS1), DRIVER3.2 (VDD), DRIVER4.2 (VDD), DRIVER4.15 (MS1), DRIVER5.2 (VDD), DRIVER6.2 (VDD), FB2.2, J11.1, J12.1, J13.1, J14.1, J15.1, J16.1, J17.1, J18.1, JS1.1, R7.2, R11.2, R15.2, R28.2, R30.2, R34.2, R35.1, R36.2, R38.2, R48.2, R49.2, SW3.3 (C), TP6.1, U1.1 (VBAT), U1.19 (VDD), U1.32 (VDD), U1.48 (VDD), U1.64 (VDD), U2.5 (OUT), U11.3 (VCC)

Notes on the sheet:
ESD USBLC6-2SC6
STM32 MCU
NRST
TMC5160 : SPI1 : USER_ADDRESS - 01
ENCODER_4
MOTOR UART ESD
TMC2209 : USART2 : ADDRESS - 00
TMC2209 : USART1 : ADDRESS - 01
ENCODER_6
MOTOR DRIVERS
BOOT
MAGNETIC ENCODERS
RPI UART ESD
3.3V VDD/VBAT
CAN
TMC2209 : USART2 : ADDRESS - 01
TMC5160 : SPI1 : USER_ADDRESS - 00
ENCODER_5
CAN CONNECTORS
SPI1 ESD
USBC 2.0
I2C NETWORK
MCU ESSENTIALS
3.3VA VDDA
ENCODER_2
24V -> 5V/3A Buck Convertor
SPI2 ESD
ENCODER_3
USB C 2.0
MCU LED
POWER RAIL 24V->5V
CRYSTAL RESONATOR
SERIAL WIRE DEBUG
STM32F446RET6 MCU
5V -> 3.3V/1A Voltage Regulator (LDO)
TMC2209 : USART1 : ADDRESS - 00
ENCODER_1
24V INPUT XT60
5V (BUCK) VS 5V (VBUS) POWER PMOS

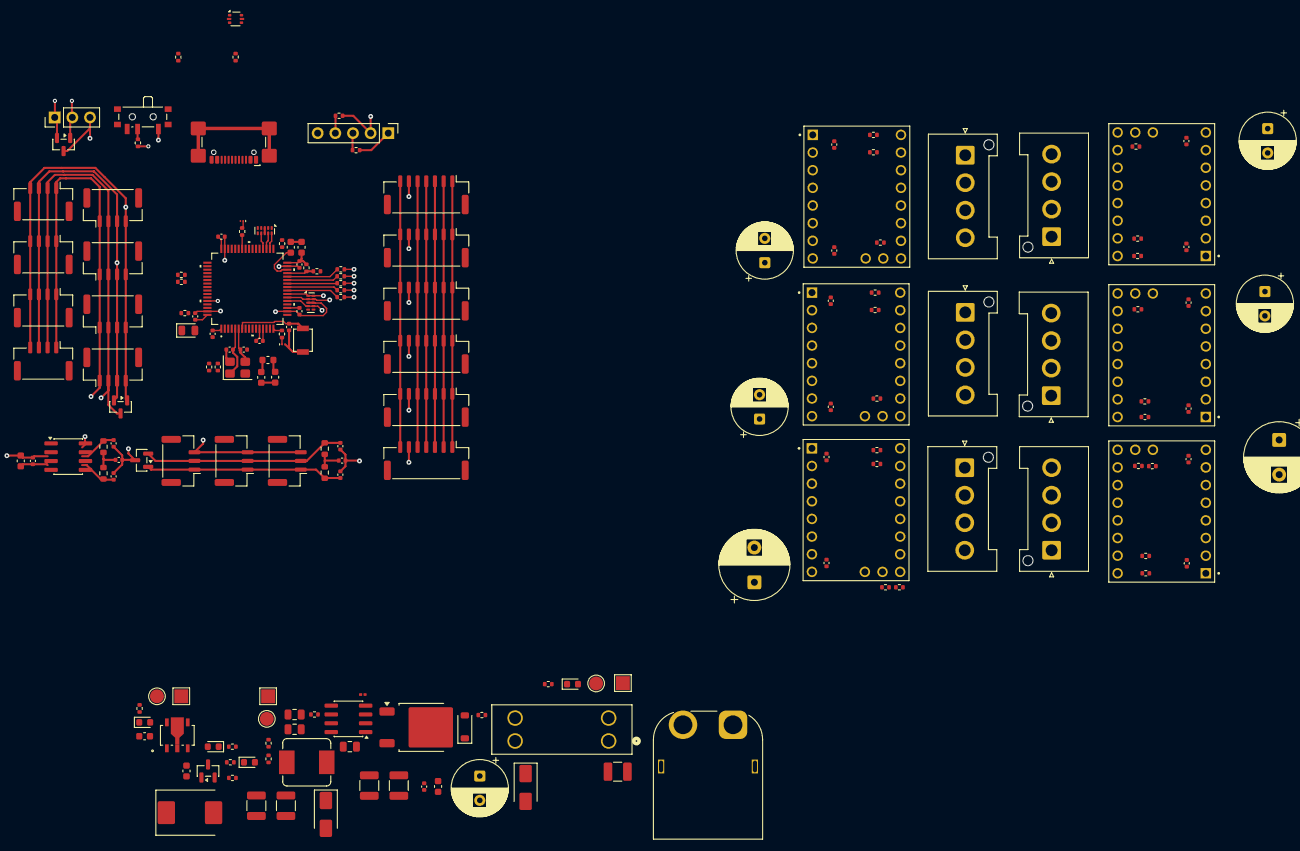
[picture p33: board voxboard.kicad_pcb from above]

Board: 4 copper layers, 174 parts (0 on the bottom side), 131 nets.
