atharvach2007/arsenal/(commit log)

2026-05-29 KICAD PROJ
    [STM32F446RET6.stp, voxboard.kicad_pcb, voxboard.kicad_sch]
2026-07-23 Updates 01
    [2209_usart1_00_voxboard.kicad_sch, 2209_usart1_01_voxboard.kicad_sch, 5160_spi1_00.kicad_sch, boot_voxboard.kicad_sch, crystal_voxboard.kicad_sch, motors_voxboard.kicad_sch, nrst_voxboard.kicad_sch, power_voxboard.kicad_sch]
2026-07-24 Revise devlog title and update USB connector details
    Updated the devlog entry to reflect changes in the USB circuitry and corrected the USB connector symbol.
