atharvach2007/arsenal/(notices)

Notices in the files:
Stage1 - STM/voxboard/voxboard.kicad_sch:
Copyright © 2026 Atharva Chauhan. All rights reserved.
